KMRHLabs/SBL-Brain-2013/Hardware/Images/Front.png

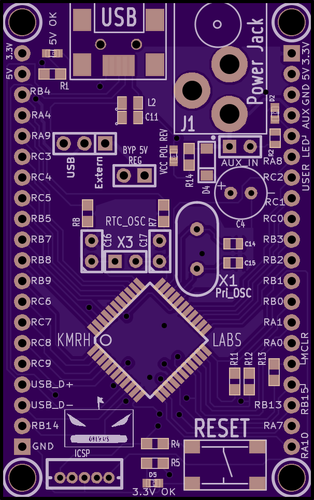
Hardware/Images/Front.png
