KMRHLabs/SBL-Brain-2013/README.md

# SBL Brain 2013

A PIC32 Microcontroller Based Dev Board

Note:
The hardware and software designs are covered under the Creative Commons Attribution-ShareAlike 4.0 International (CC BY-SA 4.0) lisence which means, you can pretty well do as you like with this project, so long as any new derivitaive works also have the same license and you keep us sited as the source of the design. 

The SBL Brain 2013 hardware and software design are "open source" projects, limitted only by a few 3rd party proprietary elements. In order to build the software, you will need to obtain some libraries that are not open source such as MicroChip's USB libraries. At the time of development, all 3rd party libraries and hardware have no licencing fee or royalty requirements. We are working towards a completely and truely open source project.
