KMRHLabs/SBL-Brain-2013/Hardware/Images/Back.png

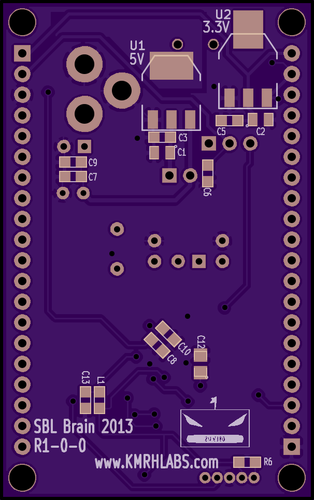
Hardware/Images/Back.png
