KMRHLabs/SBL-Brain-2013/Hardware/SBL_Brain_2013.sch

## KiCad design Hardware/SBL_Brain_2013.sch (2015-04-05)


Parts:
C1, C2, C12: 10uF
C3, C5, C6, C7: 1uF
C4: 220uF; Part Number B41827A4227M000; MouserPN 871-B41827A4227M000
C8, C9, C10, C13: 0.1uF
C11: 4.7uF
C14, C15: 18pF; Part Number GRM1885C1H180JA01D; MouserPN 81-GRM39C180J50
C16, C17: DNP
D1: 5V_Green_LED
D2: User_Green_LED
D3: POL_REV_RED
D4: MBR120VLSFT1
D5: 3.3V_Green_LED
H1: ICSP
J1: AUX_IN
J2: USB_MINI
J3: POWER_JACK
K1: Ext/USB PWR
L1, L2: FERRITE; Part Number LI0603E151R-10; MouserPN 875-LI0603E151R-10
P1: BYP_5VREG
P2, P3: CONN_20
R1, R2, R5, R14: 470
R4, R11, R12, R13: 1K
R6: 47K
R7, R8: DNP
SW1: RESET
U1: LD1117S50; Part Number LD1117S50TR
U2: SPX1117-M3; Part Number SPX1117M3-L-3-3; Mouser PN 701-SPX1117M3-L-3-3
U3: PIC32MX250F128D
X1: 4MHz; Part Number ABL-4.000MHZ-B2; MouserPN 815-ABL-4-B2
X3: DNP

Connections:
+3.3V: C2.1, C5.1, C8.1, C10.1, H1.2 (VCC), L1.2, P2.20, P3.1, R5.1, R6.2, U2.2 (Vout), U3.10 (Vusb3v3), U3.28 (Vdd), U3.40 (Vdd)
+5V: C1.1, C3.1, K1.1, P1.1, U1.2 (Vout)
GND: C1.2, C2.2, C3.2, C4.2, C5.2, C6.2, C7.2, C8.2, C9.2, C10.2, C11.2, C12.2, C13.2, C14.2, C15.2, C16.2, C17.2, D1.2 (K), D3.1 (A), D5.2 (K), H1.3 (GND), J1.2, J2.5 (GND), J3.2 (SW), J3.3 (GND), P2.1, P3.3, R2.1, SW1.2, U1.1 (GND), U2.1 (GND), U3.6 (Vss), U3.16 (AVss), U3.29 (Vss), U3.39 (Vss)
HT: U1.4 (NC)
ICSP_C: H1.5 (ICSP_CLOCK), R11.1, U3.22 (RB1/RPB1/AN3/PGEC1)
ICSP_D: H1.4 (ICSP_DATA), R12.1, U3.21 (RB0/RPB0/AN2/PGED1)
MCLR: H1.1 (_MCLR), R4.1, R6.1, R13.1, U3.18 (/MCLR)
unnamed: C12.1, U3.7 (Vcap)
unnamed: C13.1, L1.1, U3.17 (AVdd)
unnamed: D1.1 (A), R1.2
unnamed: D2.1 (A), P3.5
unnamed: D2.2 (K), R2.2
unnamed: D3.2 (K), R14.2
unnamed: D5.1 (A), R5.2
unnamed: J2.1 (VCC), L2.2
unnamed: P2.17, R8.2
unnamed: P2.18, R7.2
unnamed: P3.12, R11.2
unnamed: P3.13, R12.2
unnamed: P3.16, R13.2
unnamed: R4.2, SW1.1
OSCI: C15.1, U3.30 (RA2/RPA2/CLKI), X1.2
OSCO: C14.1, U3.31 (RA3/RPA3/CLKO), X1.1
PWR_IN: C4.1, C7.1, C9.1, D4.2 (K), P1.2 (PM), U1.3 (Vin)
Pwr_Sel: C6.1, K1.2 (PM), P2.19, P3.2, R1.1, U2.3 (Vin)
RA0: P3.15, U3.19 (RA0/RPA0/AN0)
RA1: P3.14, U3.20 (RA1/RPA1/AN1)
RA7: P3.19, U3.13 (RA7)
RA8: P3.6, U3.32 (RA8/RPA8)
RA9: P2.16, U3.35 (RA9/RPA9)
RA10: P3.20, U3.12 (RA10)
RB2: P3.11, U3.23 (RB2/SDA2/RPB2/AN4)
RB3: P3.10, U3.24 (RB3/SCL2/RPB3/AN5)
RB5: P2.12, U3.41 (RB5/RPB5)
RB7: P2.11, U3.43 (RB7/INT0/RPB7)
RB8: P2.10, U3.44 (RB8/SCL1/RPB8)
RB9: P2.9, U3.1 (RB9/RPB9/SDA1)
RB13: P3.18, U3.11 (RB13/RPB13/AN11)
RB14: P2.2, U3.14 (RB14/SCK1/RPB14/AN10)
RB15: P3.17, U3.15 (RB15/SCK2/RPB15/AN9)
RC0: P3.9, U3.25 (RC0/RPC0/AN6)
RC1: P3.8, U3.26 (RC1/RPC1/AN7)
RC2: P3.7, U3.27 (RC2/RPC2/AN8)
RC3: P2.15, U3.36 (RC3/RPC3/AN12)
RC4: P2.14, U3.37 (RC4/RPC4)
RC5: P2.13, U3.38 (RC5/RPC5)
RC6: P2.8, U3.2 (RC6/RPC6)
RC7: P2.7, U3.3 (RC7/RPC7)
RC8: P2.6, U3.4 (RC8/RPC8)
RC9: P2.5, U3.5 (RC9/RPC9)
REV_LED: D4.1 (A), J1.1, J3.1 (Vin), P3.4, R14.1
SOSCI: C17.1, R7.1, U3.33 (RB4/RPB4/SOSCI), X3.2
SOSCO: C16.1, R8.1, U3.34 (RA4/T1CK/RPA4/SOSCO), X3.1
USB_D+: J2.3 (D+), P2.4, U3.8 (RB10/D+/RPB10)
USB_D-: J2.2 (D-), P2.3, U3.9 (RB11/D-/RPB11)
USB_VCC: C11.1, K1.3, L2.1, U3.42 (Vbus)

Notes on the sheet:
100mA MAX from USB
Filter needed to remove noise from USB VCC
Add room for series resitor for VCC/USB in to filter ripple
For 3.3 VREG
Jumper to Select External Supply or USB VCC
USB Interface
1K is to protect programmer incase button is pushed.
Place Next to MCU
32.768KHz Xtal
Xtal
Optional Secondary Oscillator
Main Oscillator
Programming Header and Reset Switch
3.3V Regulator
Jumper to Bypass 5V Regulator
5V Regulator
AUX Power In Header
Power in Jack
Power OK/REV LEDS
Supply Bypass Caps
